Jeremboo/callToMake/0_ASSETS/ficheProduit.pdf

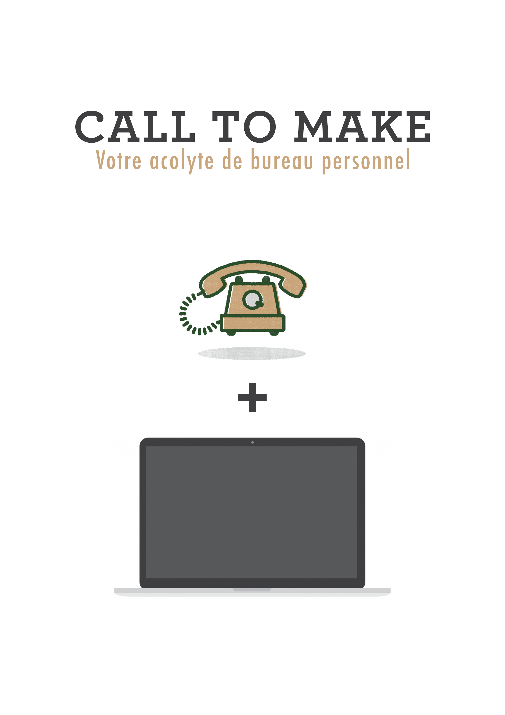
[picture p19: page 1]
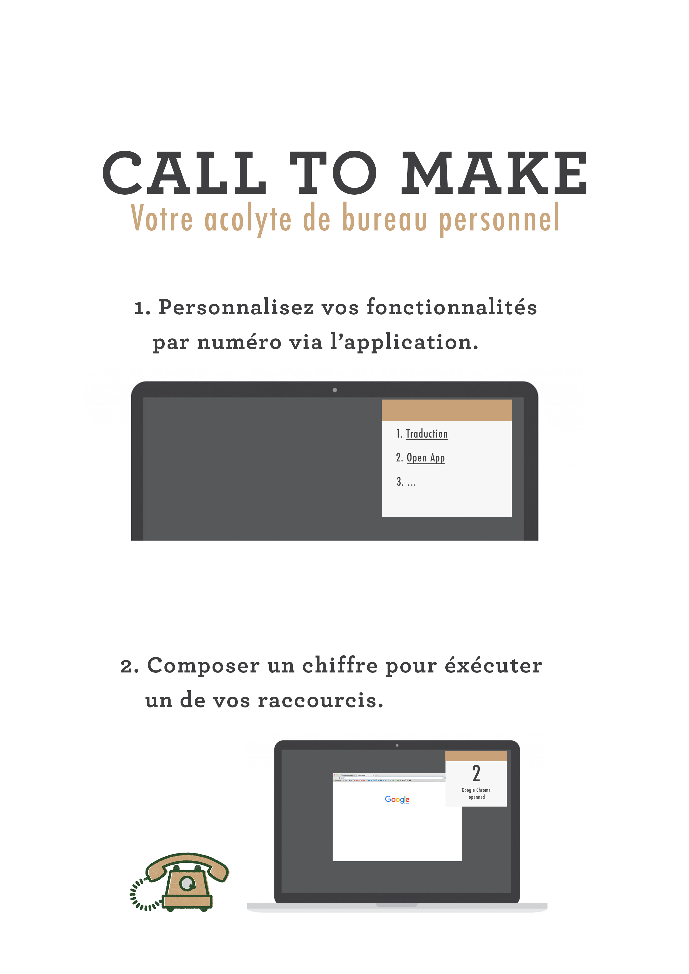
[picture p20: page 2]
