Jeremboo/callToMake/0_ASSETS/inspi/kickstarter selector.png

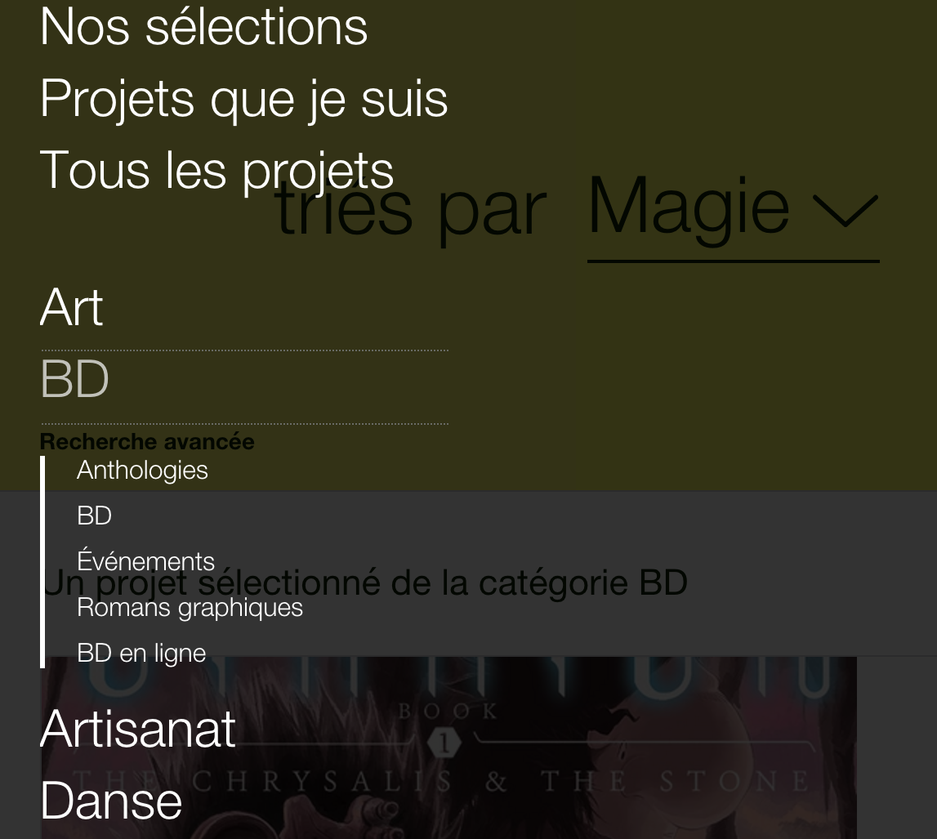
0_ASSETS/inspi/kickstarter selector.png
