Jeremboo/callToMake/0_ASSETS/inspi/list.png

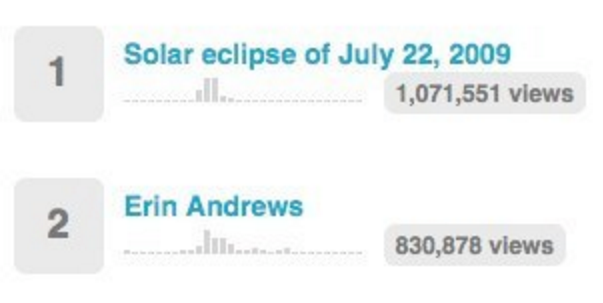
0_ASSETS/inspi/list.png
