Jeremboo/callToMake/0_ASSETS/inspi/rotaryPhone.png

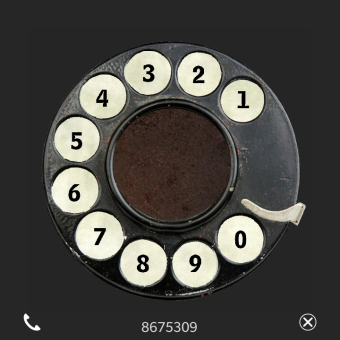
0_ASSETS/inspi/rotaryPhone.png
