Jeremboo/callToMake/0_ASSETS/inspi/topbar.png

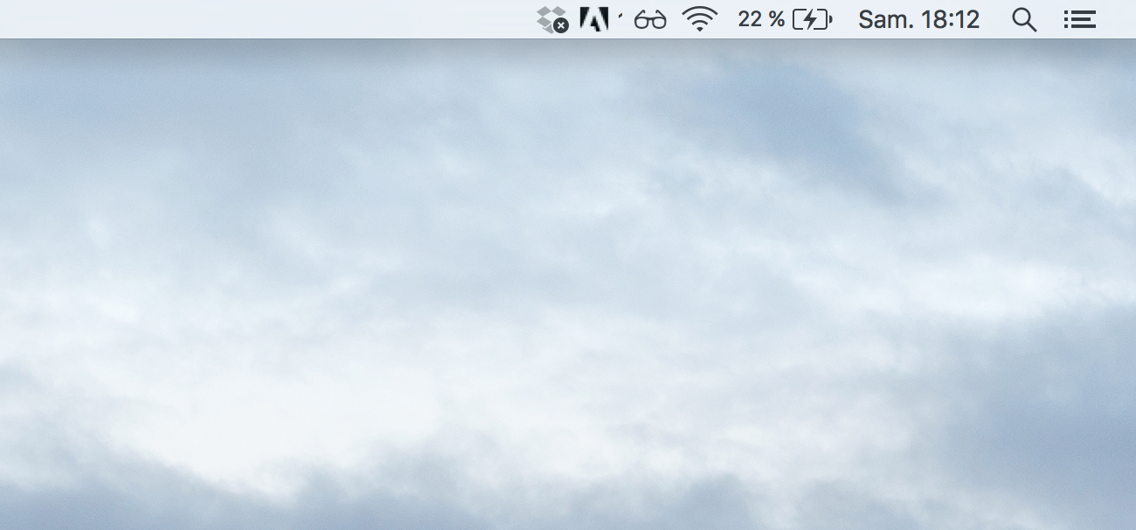
0_ASSETS/inspi/topbar.png
