Jeremboo/callToMake/0_ASSETS/inspi/widget openned.png

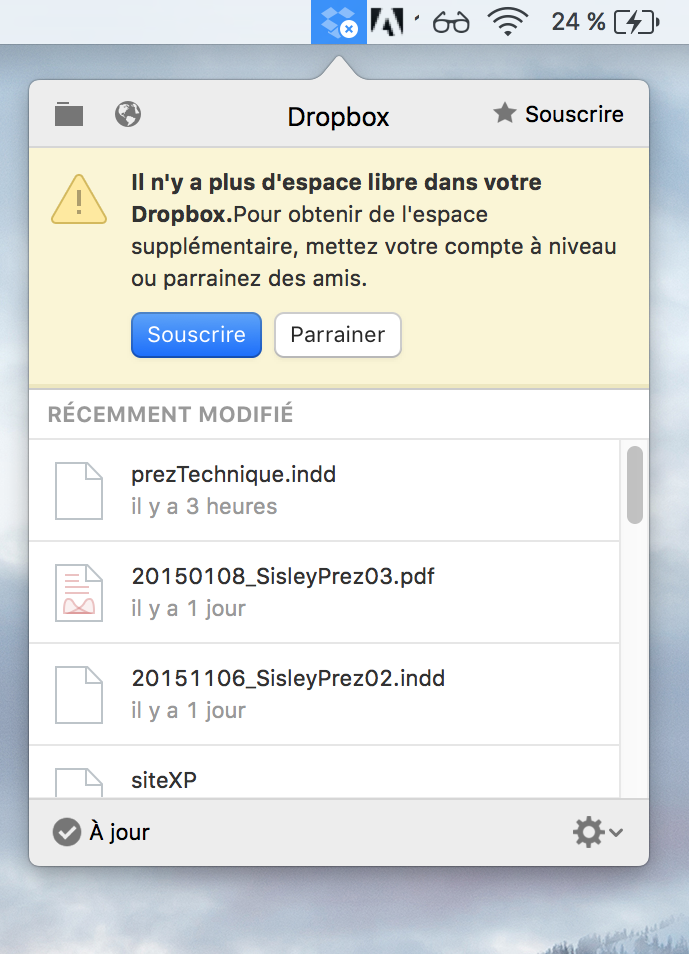
0_ASSETS/inspi/widget openned.png
