Jeremboo/callToMake/0_ASSETS/microhpone_schema.png

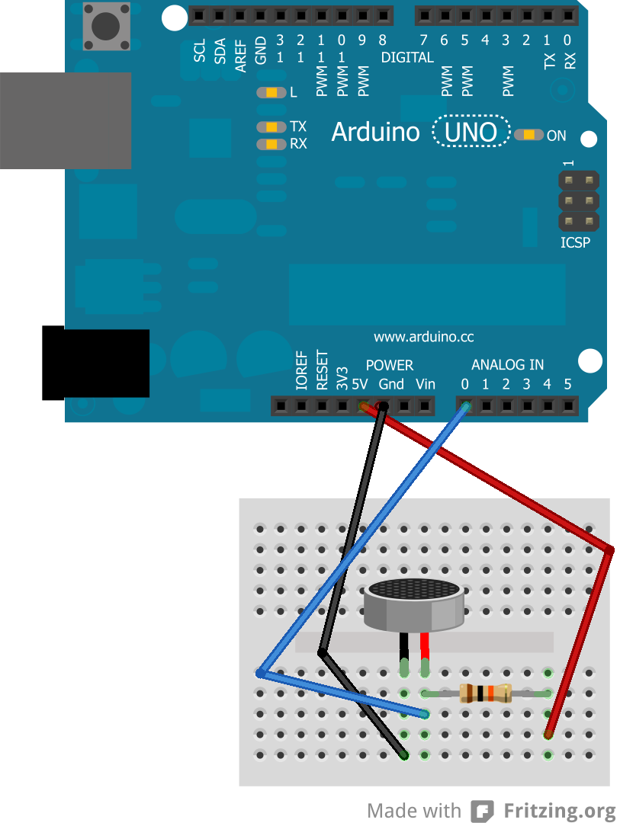
0_ASSETS/microhpone_schema.png
