Jeremboo/callToMake/0_ASSETS/photos/99_callToMake_schemaHangPickUp.jpg

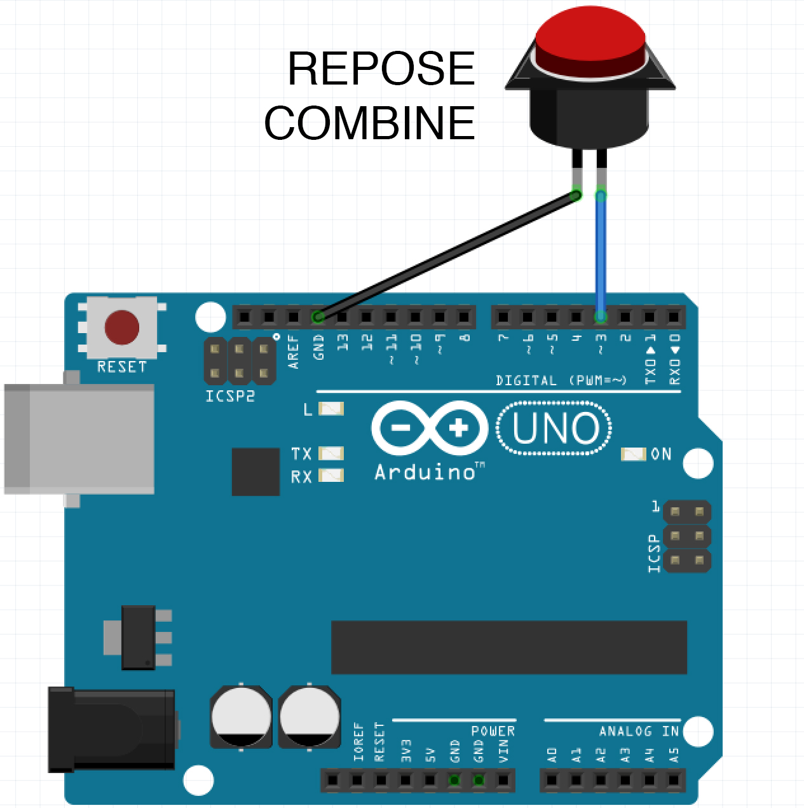
0_ASSETS/photos/99_callToMake_schemaHangPickUp.jpg
