Jeremboo/callToMake/0_ASSETS/photos/99_callToMake_schemaRotoPhone.png

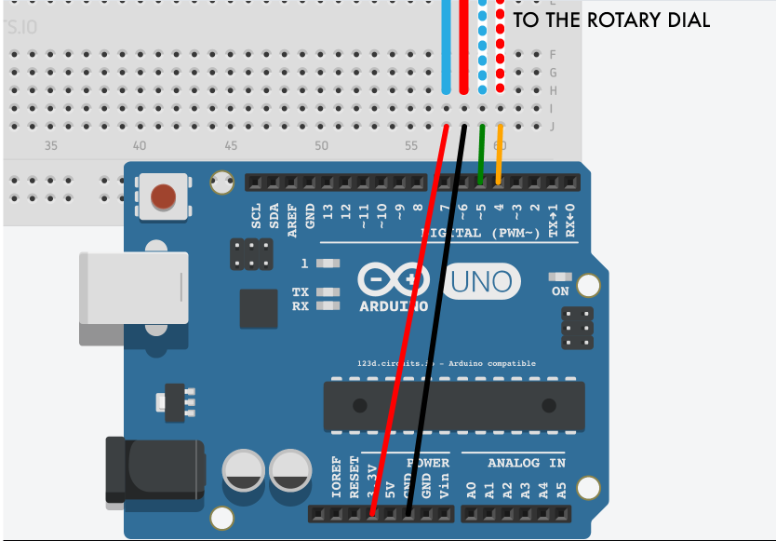
0_ASSETS/photos/99_callToMake_schemaRotoPhone.png
