Jeremboo/callToMake/(commit log)

2015-10-08 Add script to conned arduino to node server
2016-01-10 scripts for arduino to raspberry and update README.md
2016-01-12 Add node server and socket io
2016-01-12 add arduino scripts for rotaty components controller && update README.md
2016-01-13 Test on raspberry
2016-01-13 Tests raspberry #Sound
2016-01-13 update README.md and arduino scripts
2016-01-14 parse info received to Arduino
2016-01-14 add forgetted server socket
